prankard/gaggiuino_front_panel/stl/FlexiblePanel.stl

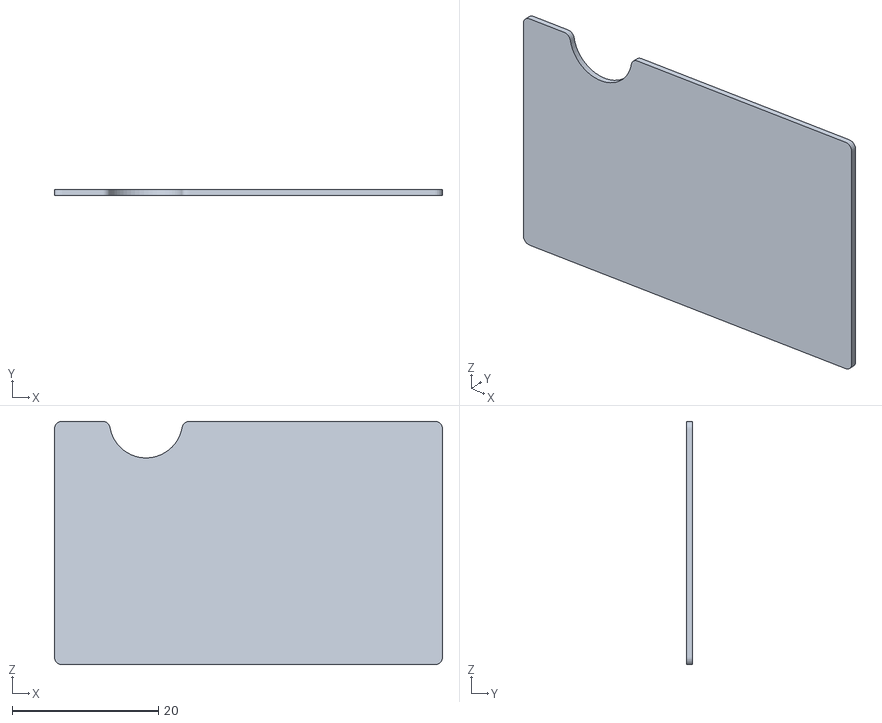
[picture p5: CAD file, 2024-02-17]
stl/FlexiblePanel.stl
53.1 x 0.8 x 33.3
