prankard/gaggiuino_front_panel/stl/FrontPanel.stl

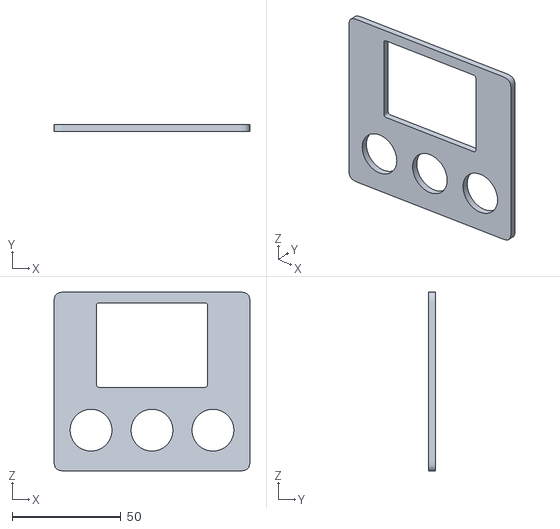
[picture p6: CAD file, 2024-02-17]
stl/FrontPanel.stl
90.0 x 3.00 x 82.1
