prankard/gaggiuino_front_panel/stl/ConnectingClip.stl

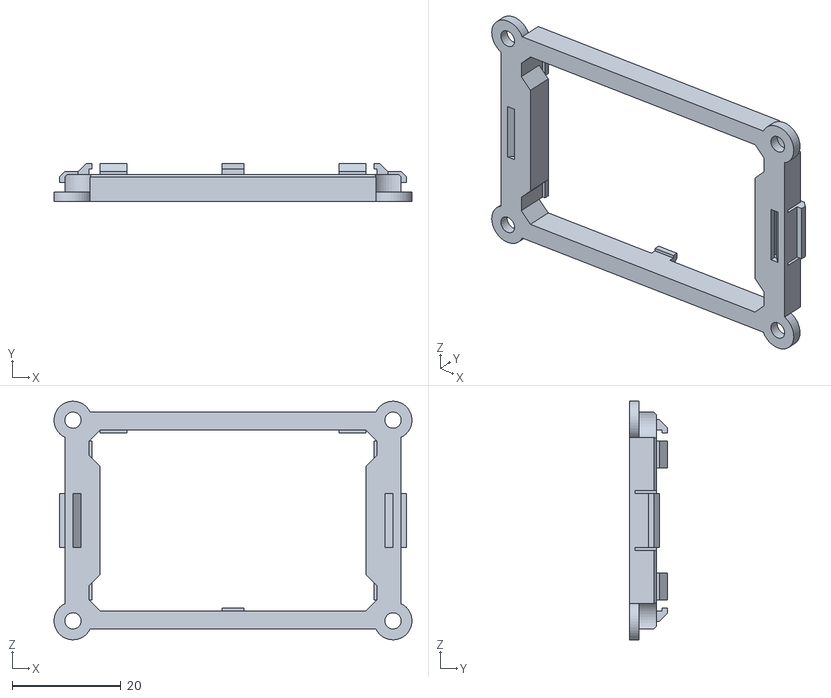
[picture p7: CAD file, 2024-02-17]
stl/ConnectingClip.stl
66.0 x 7.00 x 44.0
