prankard/gaggiuino_front_panel/stl/GaggiaPanelMirror.stl

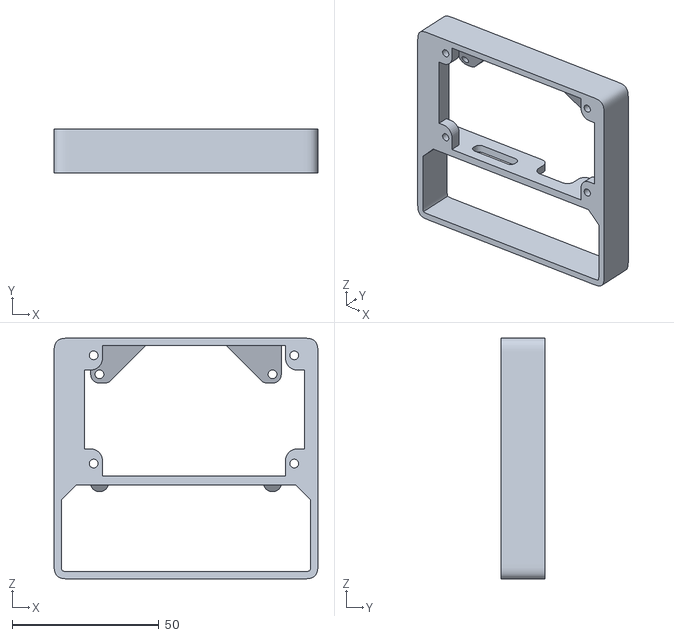
[picture p8: CAD file, 2024-02-17]
stl/GaggiaPanelMirror.stl
90.0 x 15.0 x 82.1
