prankard/gaggiuino_front_panel/(list of files, cad)

Other CAD files:
cad/Gaggiuino-Front-Panel.f3d
